twelvesec/PwnPad/challenges/6. Hard Leak.md

# **Challenge 6: "Hard Leak"**

You've managed to extract a mysterious device from a corporate blacksite. After digging into the firmware, you realize there's **nothing useful stored in Flash**, but there's one more place secrets like to hide: the **internal EEPROM**.

**Your mission is clear:**

1. **Identify how to access the internal EEPROM** of the device using ISP or other means.  
2. **Recover the hidden flag** from the leaked EEPROM data.  

## Challenge Select  
1 --> 0  
2 --> 1  
3 --> 1  
4 --> 0  
5 --> 0
