twelvesec/PwnPad/docs/img/pwnpad-board.png

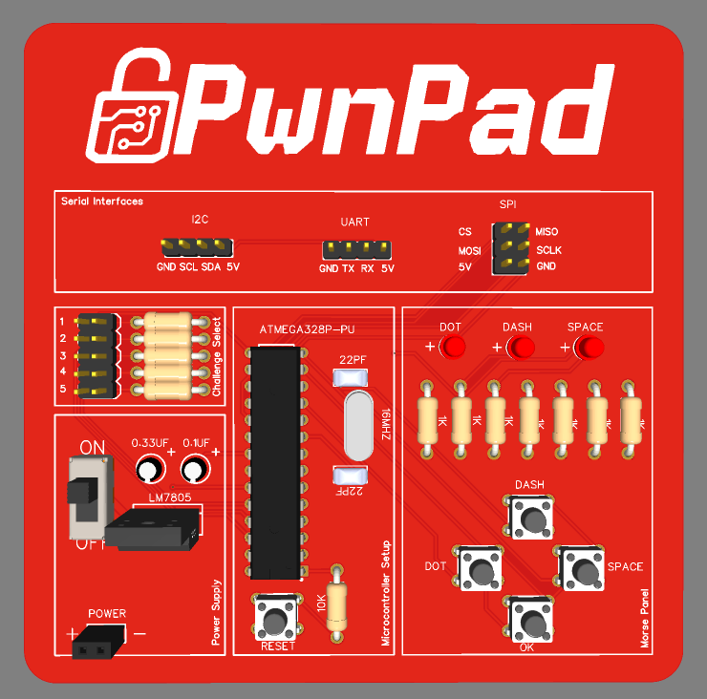
docs/img/pwnpad-board.png
