twelvesec/PwnPad/hardware/BOM/PwnPad_BOM.xlsx

Sheet: PwnPad
Description | Part Number | Quantity | Supplier
Microcontroller | ATMEGA328P-PU | 1 | https://grobotronics.com/atmega328p-with-arduino-bootloader-bundle.html
Microcontroller Socket DIP28 | N/A | 1 | https://grobotronics.com/atmega328p-with-arduino-bootloader-bundle.html
Switch Mini SPDT - 0.3A/30VDC | SS-12D00G2 | 1 | https://grobotronics.com/mini-spdt-0.3a-30vdc.html
Tact Switch 6x6mm 5mm | BTT-A06-5.0 | 5 | https://grobotronics.com/tact-switch-6x6mm-5mmbtt-a06-5.0.html
Dc Power Jack 5.5 x 2.1mm | PC-GK2.1 | 1 | https://grobotronics.com/dc-power-jack-5.5-x-2.1mm.html
Male Pin Headers 2x5 2.54mm | N/A | 1 | https://grobotronics.com/pin-header-2x40-male-2.54-mm.html
Male Pin Headers 2x3 2.54mm | N/A | 1 | https://grobotronics.com/pin-header-2x3-male-0.1.html
Male Pin Headers 1x4 2.54mm | N/A | 3 | https://grobotronics.com/pin-header-1x40-male-2.54-mm-black.html
Male Pin Headers 1x2 2.54mm | N/A | 5 | https://grobotronics.com/pin-header-1x40-male-2.54-mm-black.html
Resistor 1/4W Carbon 5% 220R | N/A | 5 | https://grobotronics.com/resistor-carbon-1-4w-5.html?variation_id=8289
Resistor 1/4W Carbon 5% 100R | N/A | 1 | https://grobotronics.com/resistor-carbon-1-4w-5.html?variation_id=8285
Resistor 1/4W Carbon 5% 10K | N/A | 1 | https://grobotronics.com/resistor-carbon-1-4w-5.html?variation_id=8310
Resistor 1/4W Carbon 5% 1K | N/A | 7 | https://grobotronics.com/resistor-carbon-1-4w-5.html?variation_id=8299
Capacitor Ceramic 22pF 50VDC | N/A | 2 | https://grobotronics.com/atmega328p-with-arduino-bootloader-bundle.html
Electrolytic Capacitor 0.1 uF 50VDC | N/A | 1 | https://grobotronics.com/atmega328p-with-arduino-bootloader-bundle.html
Electrolytic Capacitor 0.33uF 50VDC | N/A | 1 | https://grobotronics.com/atmega328p-with-arduino-bootloader-bundle.html
Jumper Pin Female 2.54mm 2-Pin | N/A | 7 | https://grobotronics.com/jumper-pin-female-2.54mm-2-pin-red-holder.html
Crystal Oscillator 16MHz | CY16BPS | 1 | https://grobotronics.com/atmega328p-with-arduino-bootloader-bundle.html
5V Voltage Regulator | LM7805 | 1 | https://grobotronics.com/atmega328p-with-arduino-bootloader-bundle.html
Female Pin Headers 1x12 2.54mm | N/A | 2 | https://grobotronics.com/pin-header-1x12-long-stackable.html

Sheet: Power Supply
Description | Part Number | Quantity | Supplier
Power Supply 9V 5A - Jack 5.5/2.1 | PSU-9V5A-5.5-2.1-EU | 1 | https://grobotronics.com/power-supply-5v-5a-jack-5-5-2-1-clone.html
9V Battery Jack adapter | N/A | 1 | https://grobotronics.com/arduino-9v-jack-adapter.html
Battery 9V | N/A | 1 | https://grobotronics.com/battery-9v-varta-longlife-550mah.html

Sheet: EEPROM Module
Description | Part Number | Quantity | Supplier
EEPROM 32K-Bit I2C Serial EEPROM | CAT24C32WI-GT3 | 1 | https://eu.mouser.com/ProductDetail/onsemi/CAT24C32WI-GT3?qs=rZgeL6XvLwaTa79VuYkKQA%3D%3D
Resistor 1/4W Carbon 5% 220R | N/A | 1 | https://grobotronics.com/resistor-carbon-1-4w-5.html?variation_id=8289
Female Pin Headers 1x12 2.54mm | N/A | 2 | https://grobotronics.com/pin-header-1x12-long-stackable.html
Resistor 1/4W Carbon 5% 10K | N/A | 2 | https://grobotronics.com/resistor-carbon-1-4w-5.html?variation_id=8310

Sheet: BLE Module
Description | Part Number | Quantity | Supplier
Bluetooth Module for Arduino - AT09 | AT-09 | 1 | https://grobotronics.com/bluetooth-module-for-arduino-at09.html
Female Pin Headers 1x12 2.54mm | N/A | 2 | https://grobotronics.com/pin-header-1x12-long-stackable.html

Sheet: Prototype Module
Description | Part Number | Quantity | Supplier
Female Pin Headers 1x12 2.54mm | N/A | 2 | https://grobotronics.com/pin-header-1x12-long-stackable.html

Sheet: WiFi Module
Description | Part Number | Quantity | Supplier
ESP8266 WiFi Module | ESP8266-01 | 1 | https://grobotronics.com/esp8266-wifi-module.html
Female Pin Headers 1x12 2.54mm | N/A | 2 | https://grobotronics.com/pin-header-1x12-long-stackable.html
Resistor 1/4W Carbon 5% 220R | N/A | 1 | https://grobotronics.com/resistor-carbon-1-4w-5.html?variation_id=8289
Resistor 1/4W Carbon 5% 430R | N/A | 1 | https://grobotronics.com/resistor-carbon-1-4w-5.html?variation_id=8294
Capacitor Ceramic Monolithic 10nF | N/A | 1 | https://grobotronics.com/10nf.html

Sheet: STM32 Module
Description | Part Number | Quantity | Supplier
STM32 ARM System Development Board ( STM32F103C8T6) | N/A | 1 | https://www.hellasdigital.gr/electronics/microcontrollers/stm32-arm-system-development-board-stm32f103c8t6/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
Female Pin Headers 1x12 2.54mm | N/A | 2 | https://grobotronics.com/pin-header-1x12-long-stackable.html
Male Pin Headers 1x3 2.54mm | N/A | 1 | https://grobotronics.com/pin-header-1x40-male-2.54-mm-black.html
