twelvesec/PwnPad/hardware/3D_files/OBJ_PCB_PwnPad v1.0.obj

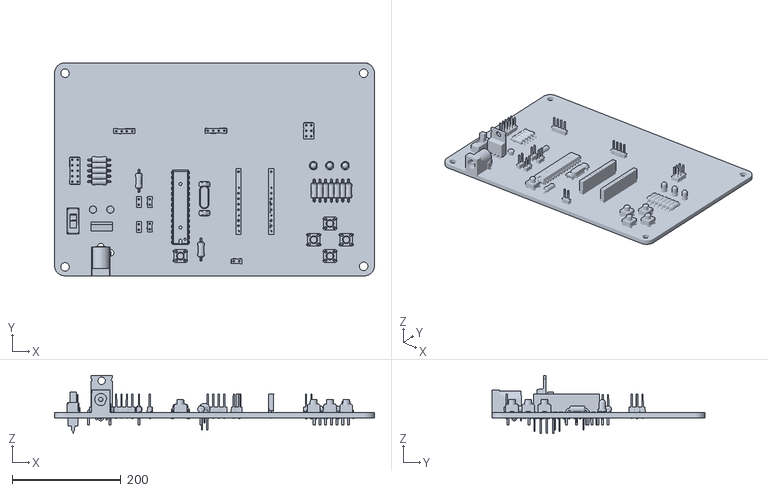
[picture p6: CAD file, 2025-12-05]
hardware/3D_files/OBJ_PCB_PwnPad v1.0.obj
589.3 x 392.8 x 107.7
