twelvesec/PwnPad/(threads)

Thread 1 (2025-08-20):

Kicad Project

kevthehermit, 2025-08-20:
I have assembled a couple of boards and identified a couple of problems with Floating Pins. I will raise a new issue for this, but I wanted to do a hardware revision to fix the problem rather than just open an issue. I could not see the actual kicad project, only the gerbers.

Are you able to share?

Thread 2 (2025-08-20):

Self Destruct Button

CR-DMcDonald, 2025-08-20:
### Issue Description

Been looking over the PCB design with @kevthehermit, and I noticed this.

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

This switch connects your 5v rail directly to ground, leading to a short circuit if this button is pressed. @kevthehermit confirmed this on a printed and populated board by testing continuity between the 5v UART PIN and ground while the button was pressed without the battery inserted.

Pressing the reset button while a battery is inserted would lead to the 5v regulator burning out immediately.

### Recommendation

A resistor needs to be in the path between 5v and ground. Users with existing boards should not populate this switch. If you release the KiCAD files happy to work with @kevthehermit to update the design.

Alternatively relabel the reset switch to "Self Destruct". 🙂
