twelvesec/PwnPad/hardware/schematics/Schematic_PwnPad-v1.0.pdf

### GND

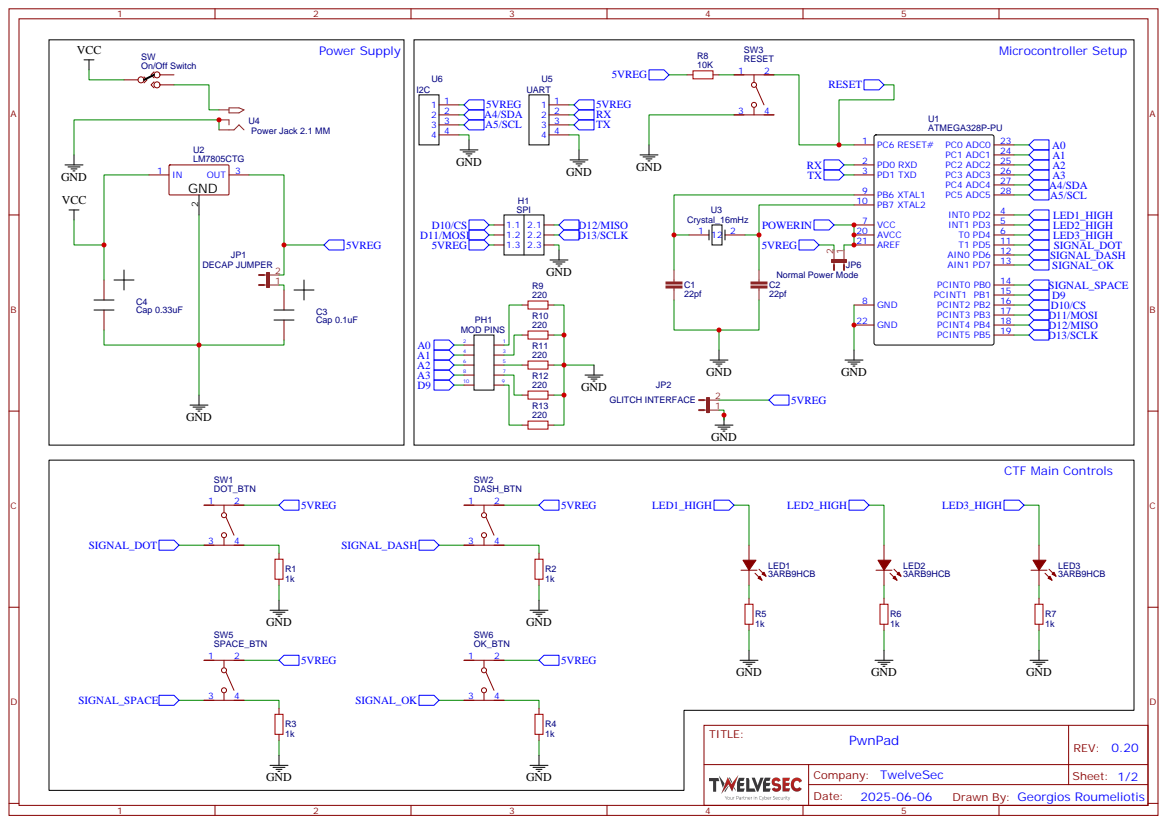
[picture p7: page 1]

Drawn By: Georgios Roumeliotis

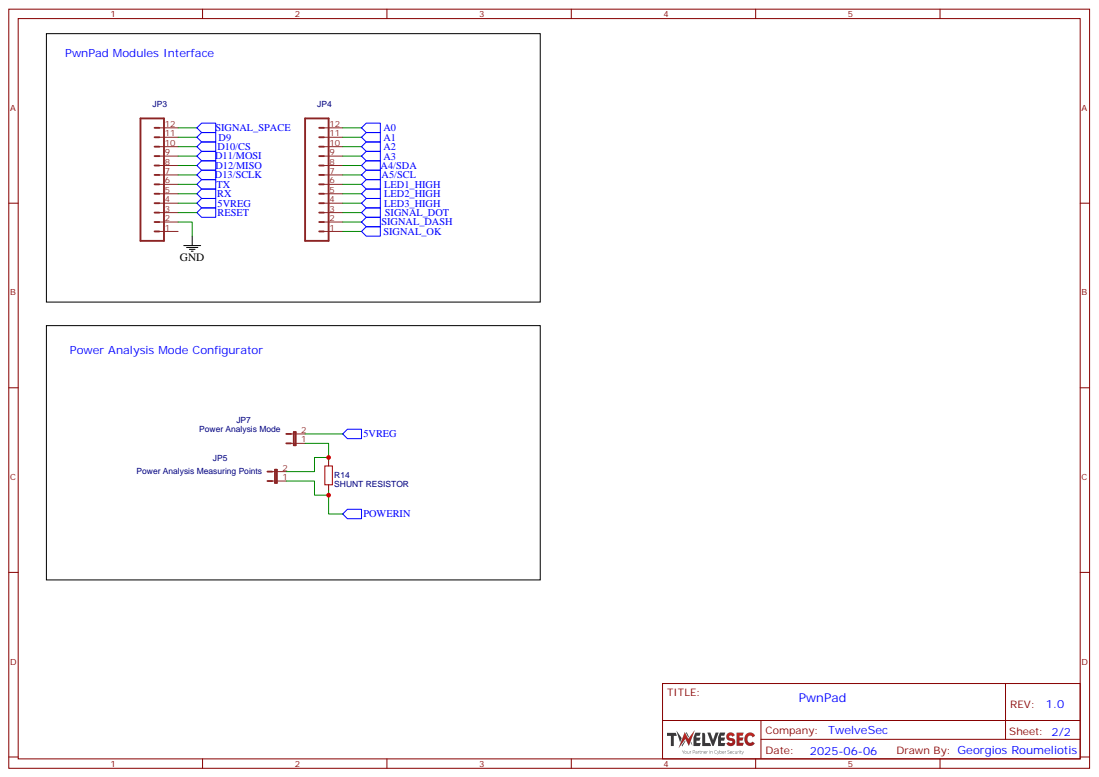
[picture p8: page 2]

Power Analysis Mode Configurator

Power Analysis Measuring Points

Drawn By: Georgios Roumeliotis
