twelvesec/PwnPad/modules/Module Dimensions Guide.pdf

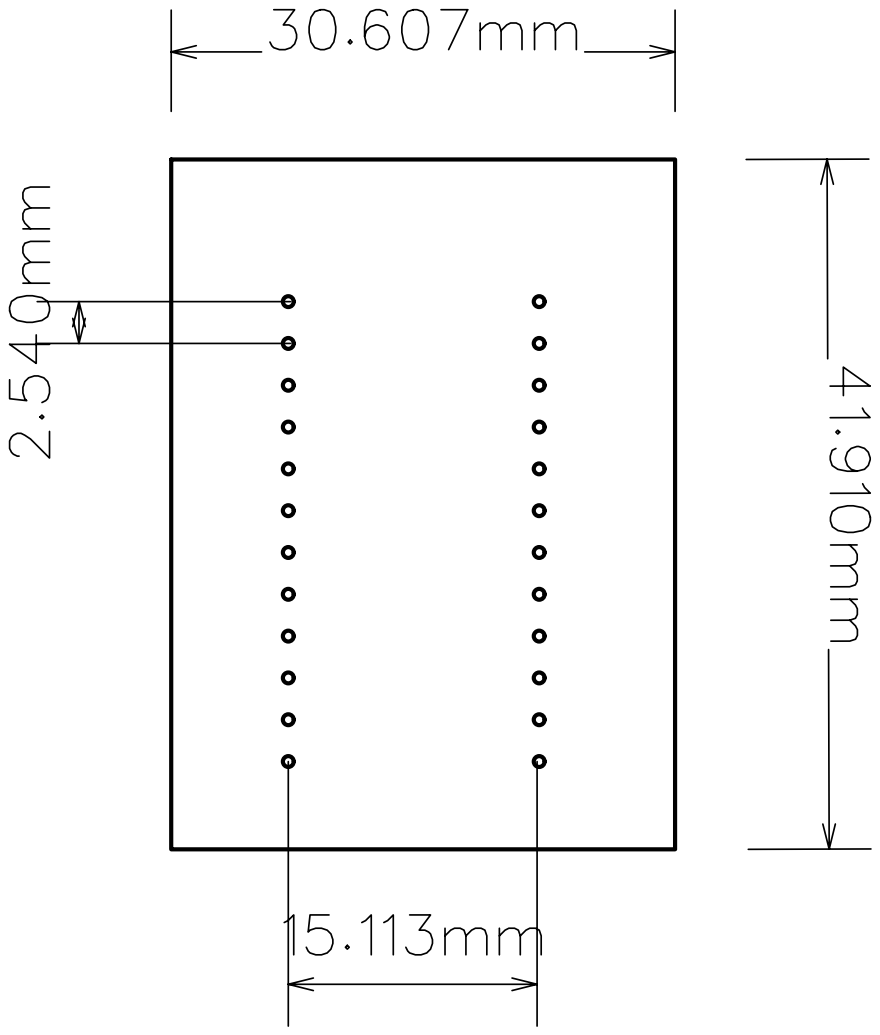
[picture p9: page 1]
