twelvesec/PwnPad/hardware/board_layout/PCB_PCB_PwnPad-v1.0.pdf

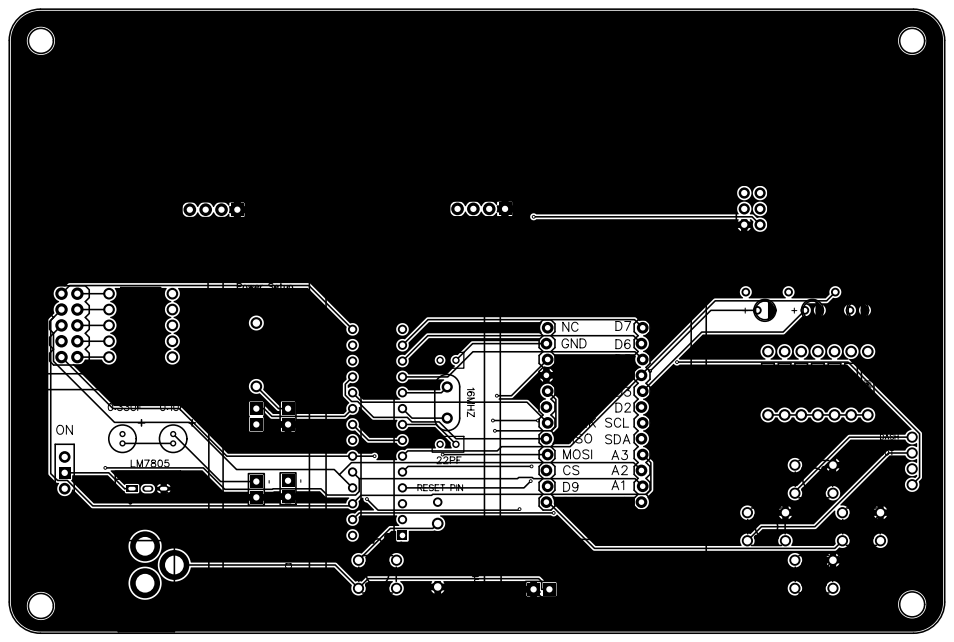
[picture p10: page 1]
