twelvesec/PwnPad/modules/BLE/schematic/BLE-Module.pdf

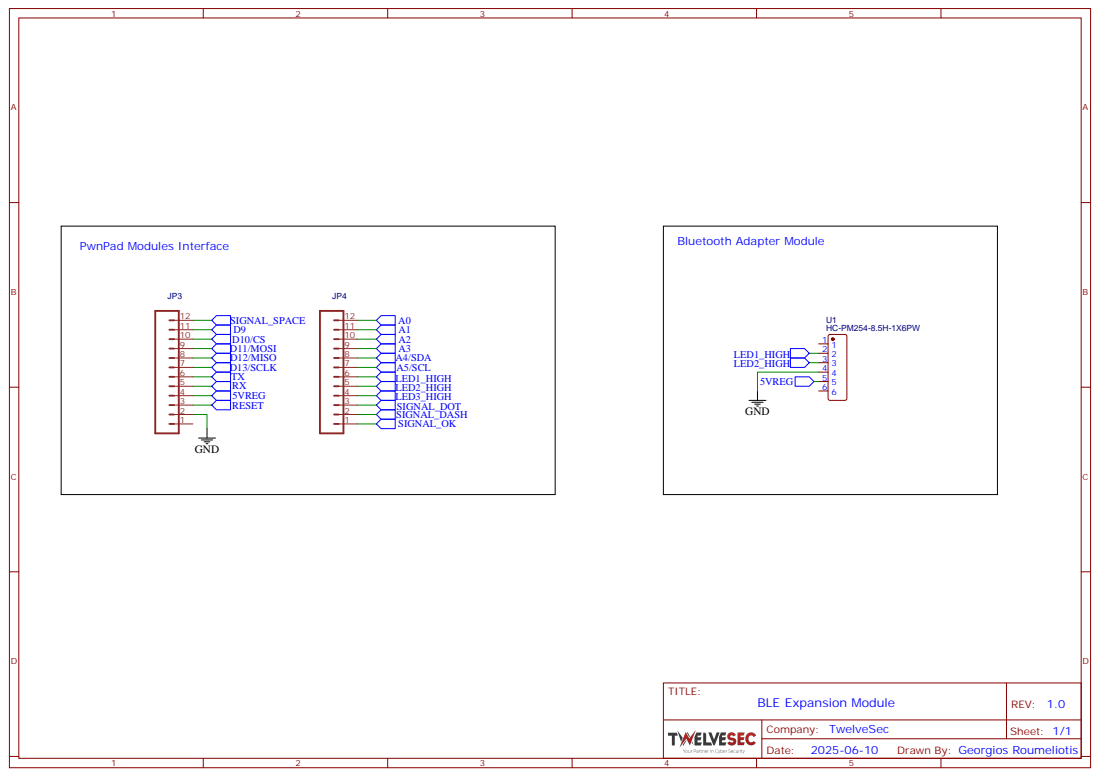
[picture p11: page 1]

Drawn By: Georgios Roumeliotis
