twelvesec/PwnPad/modules/I2C EEPROM/schematic/I2C-EEPROM-Module.pdf

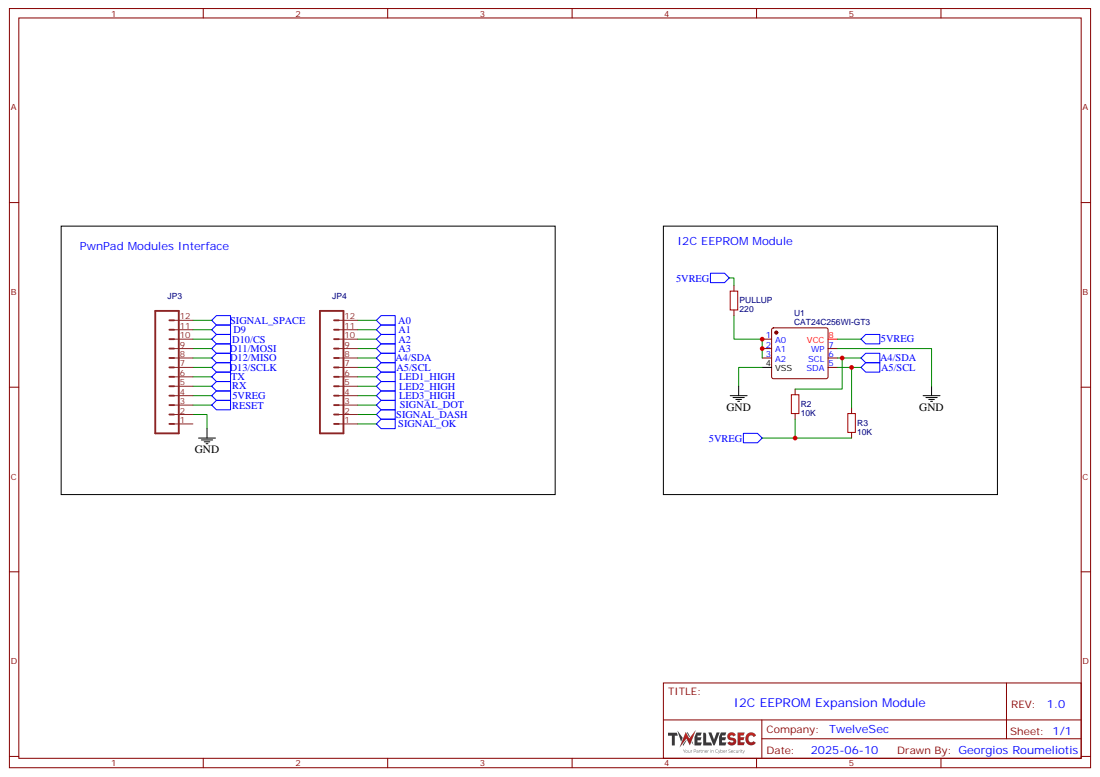
[picture p12: page 1]

Drawn By: Georgios Roumeliotis
