twelvesec/PwnPad/modules/Protoboard/schematic/Prototype-Module.pdf

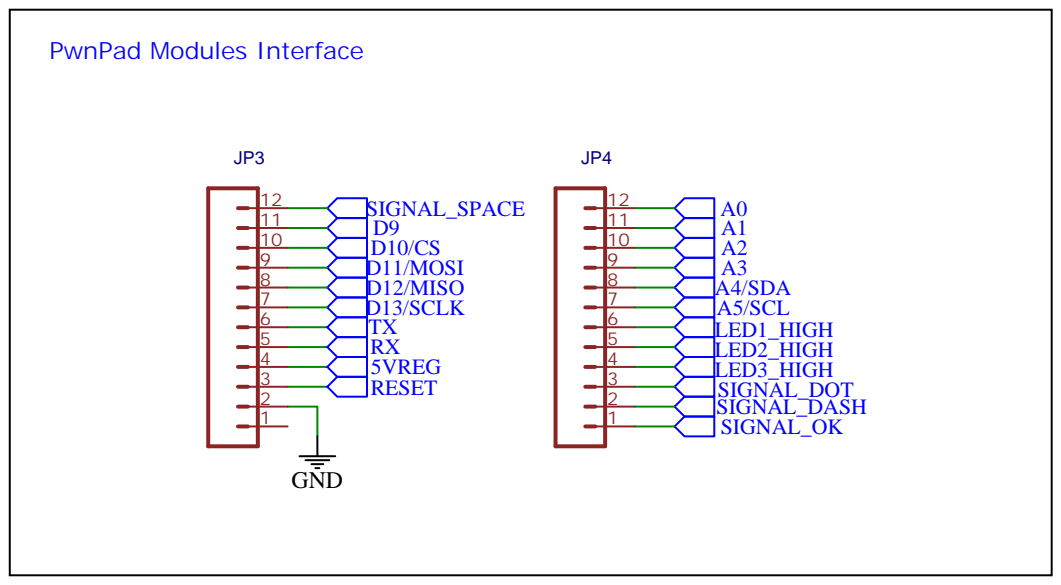
[picture p13: page 1]

Drawn By: Georgios Roumeliotis
