twelvesec/PwnPad/modules/STM32F1x/schematic/Schematic_PwnPad-STM32-Module.pdf

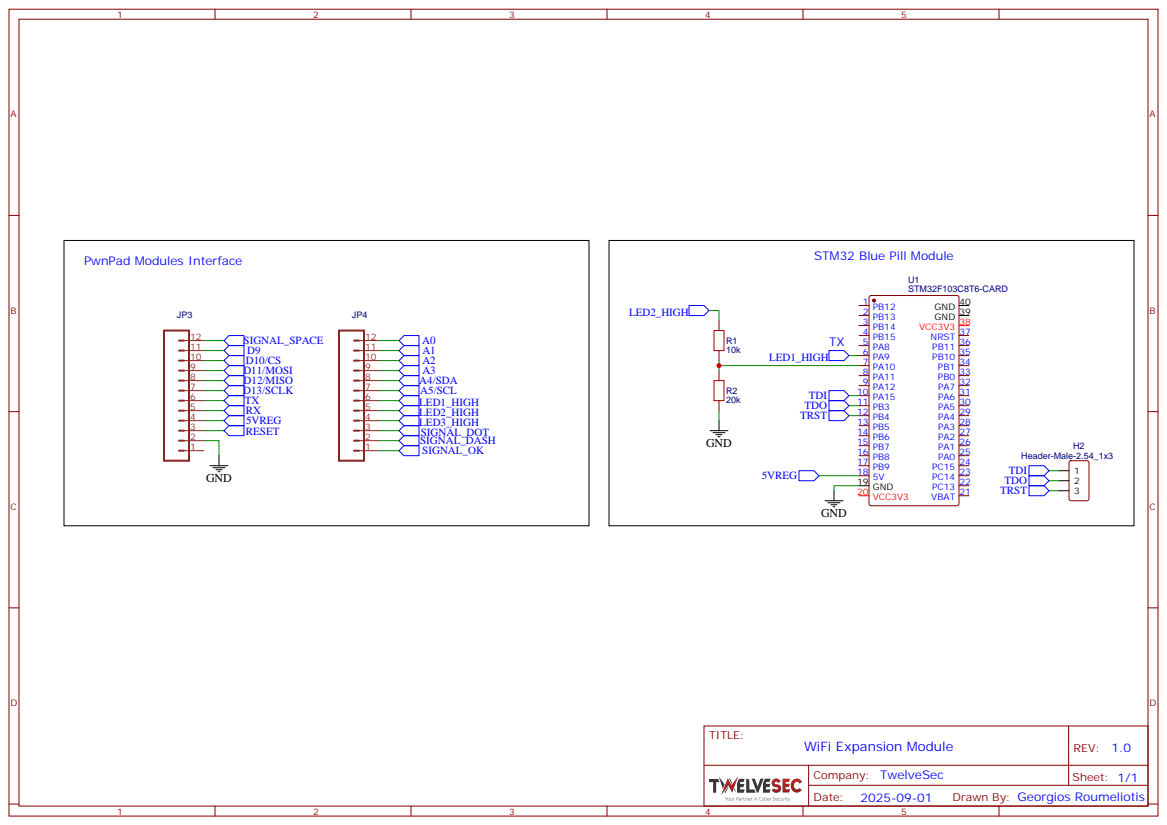
[picture p14: page 1]

Drawn By: Georgios Roumeliotis
