twelvesec/PwnPad/hardware/schematics/Schematic_PwnPad_v0.10.pdf

## Power Supply

SW | Microcontroller Setup

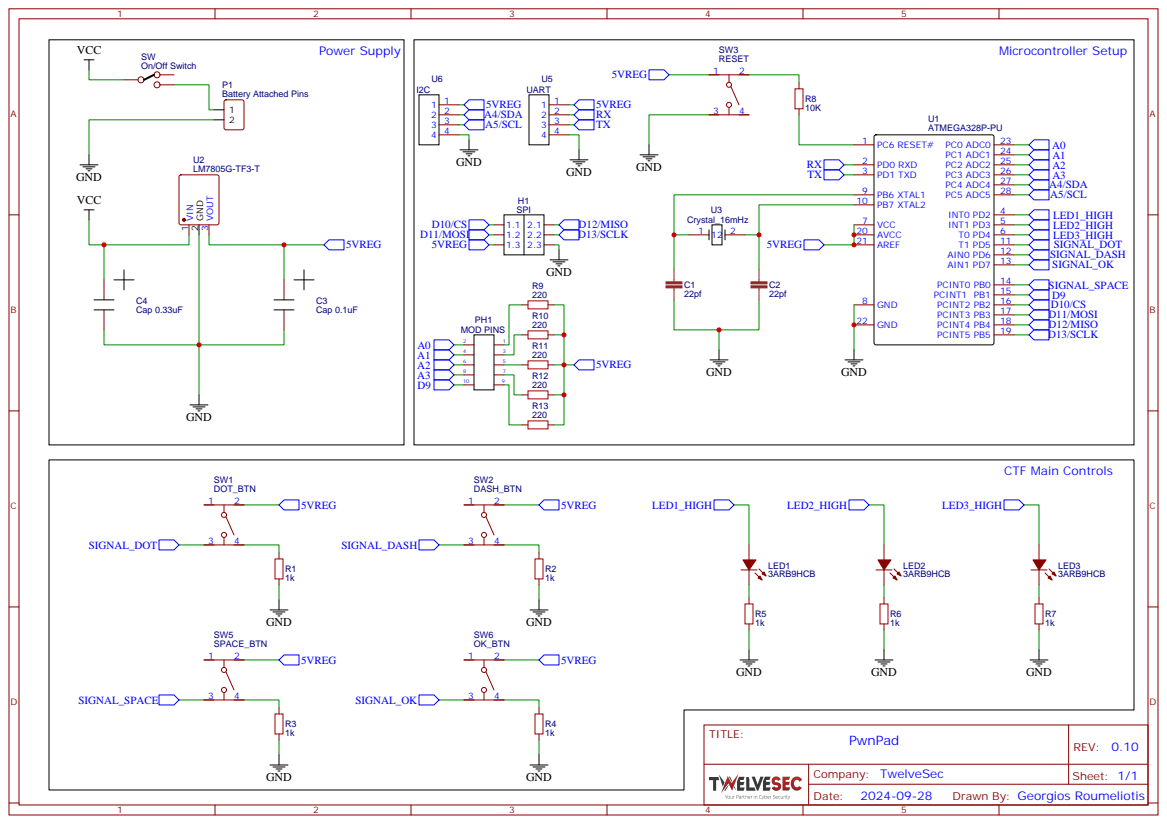
[picture p15: page 1]

Drawn By: Georgios Roumeliotis
