twelvesec/PwnPad/(commit log)

2025-06-02 Add files via upload
    Initial commit of PwnPad version 0.10
    [BOM_PwnPad_v0.10.csv]
2025-12-05 PwnPad v1.0 New Release
    [BOM_PwnPad_v0.10.csv, OBJ_PCB_PwnPad v1.0.obj, OBJ_PCB_PwnPad.obj, PwnPad_BOM.xlsx]
